UnHombreAlto/Bachelor_Biosignalgenerator_HTWK/Platinen_Design/Platine_1/WhatsApp Image 2026-09-02 at 13.56.45(1).jpeg

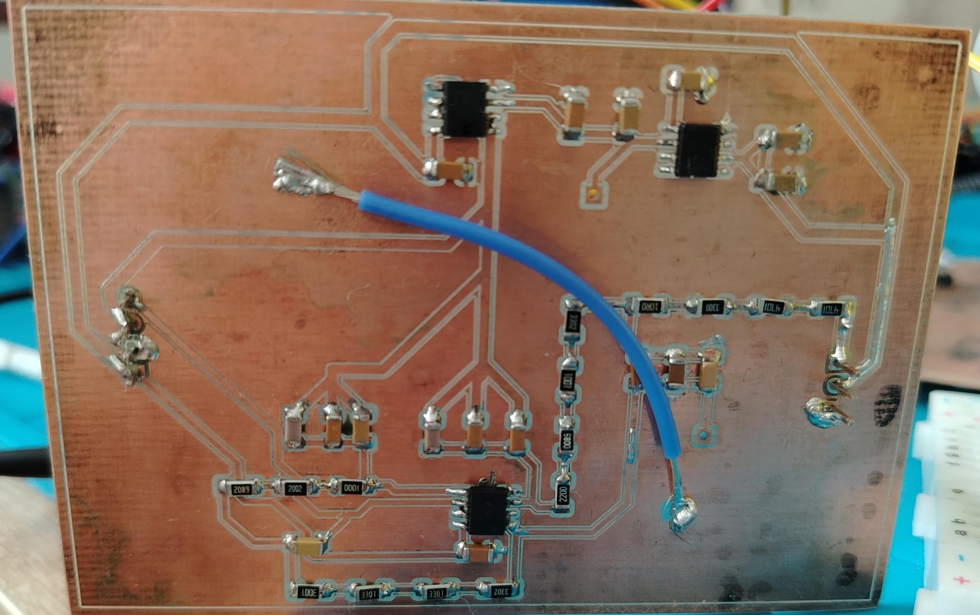
Platinen_Design/Platine_1/WhatsApp Image 2026-09-02 at 13.56.45(1).jpeg
