UnHombreAlto/Bachelor_Biosignalgenerator_HTWK/Platinen_Design/Platine_2/WhatsApp Image 2026-09-02 at 13.56.45.jpeg

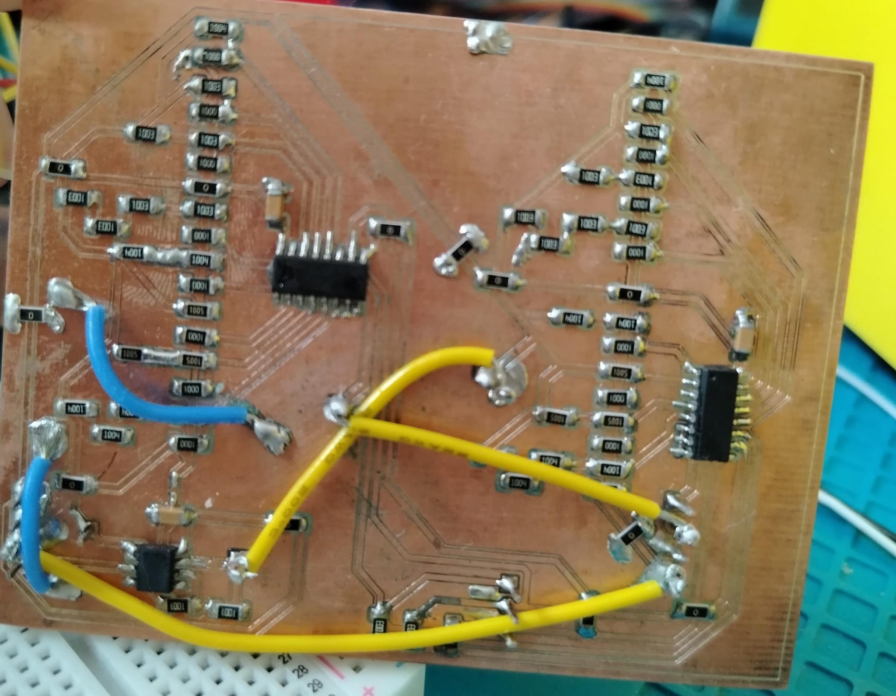
Platinen_Design/Platine_2/WhatsApp Image 2026-09-02 at 13.56.45.jpeg
