UnHombreAlto/Bachelor_Biosignalgenerator_HTWK/README.md

# Bachelor_Biosignalgenerator_HTWK
Sammlung des Materials zur Bachelorarbeit Biosignalgenerator
