UnHombreAlto/Bachelor_Biosignalgenerator_HTWK/erste_Versuche/WhatsApp Image 2026-09-02 at 13.54.11.jpeg

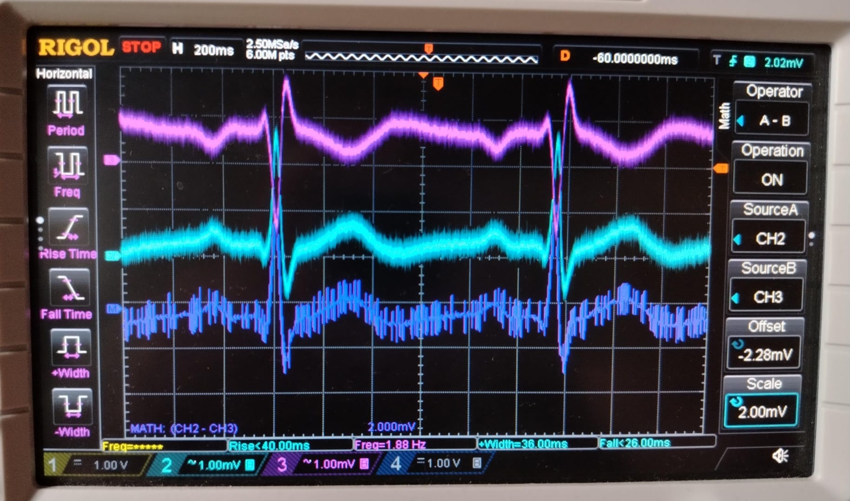
erste_Versuche/WhatsApp Image 2026-09-02 at 13.54.11.jpeg
