UnHombreAlto/Bachelor_Biosignalgenerator_HTWK/Gehäuse_Desgin/Biosignal.FCStd

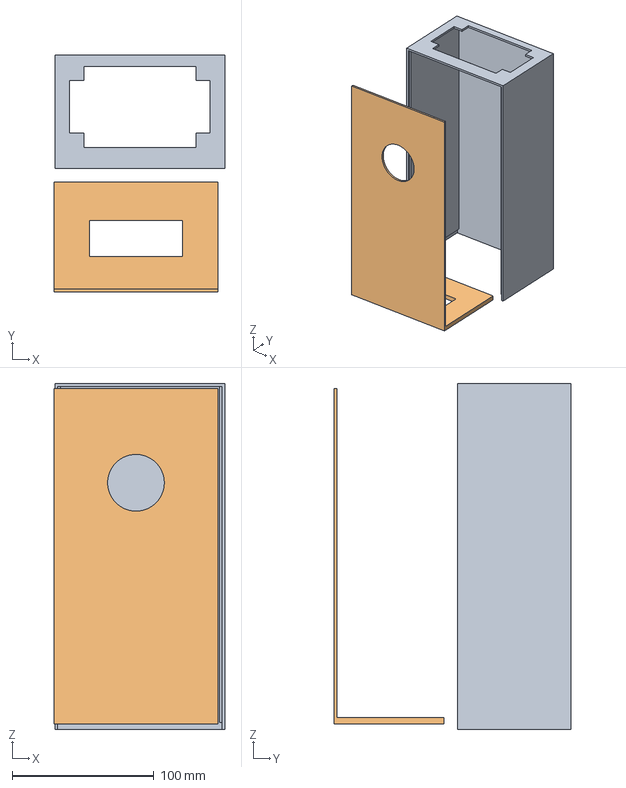
[picture p4: CAD file, 2026-09-08]
Gehäuse_Desgin/Biosignal.FCStd
120.5 x 167.0 x 244.0 mm
Base_Plate
Lid
