UnHombreAlto/Bachelor_Biosignalgenerator_HTWK/Platinen_Design/Platine_2/BiosignalGEN_SOIC_Klein.kicad_pcb

## KiCad design Platinen_Design/Platine_2/BiosignalGEN_SOIC_Klein.kicad_pcb (2026-09-02)

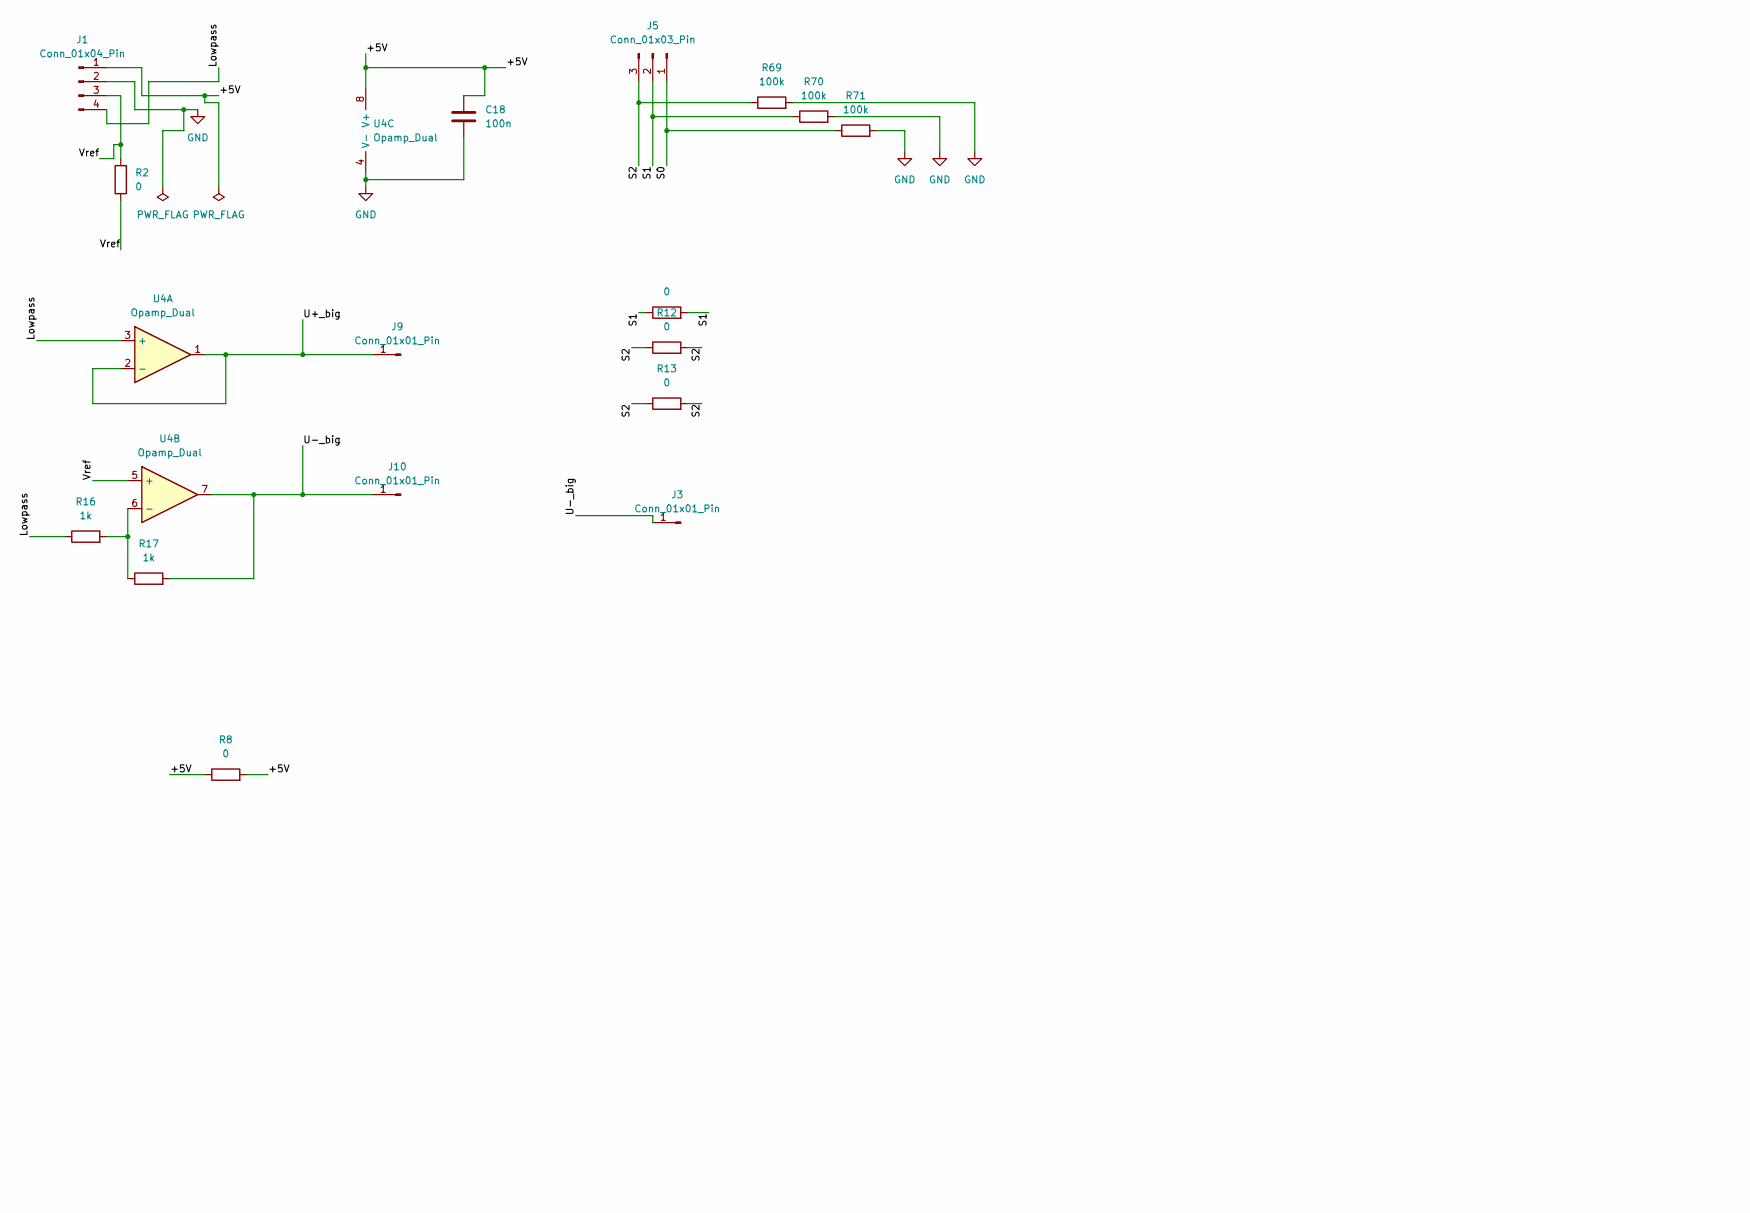
[picture p5: schematic BiosignalGEN_SOIC_Klein.kicad_sch, part in row 1, column 1]

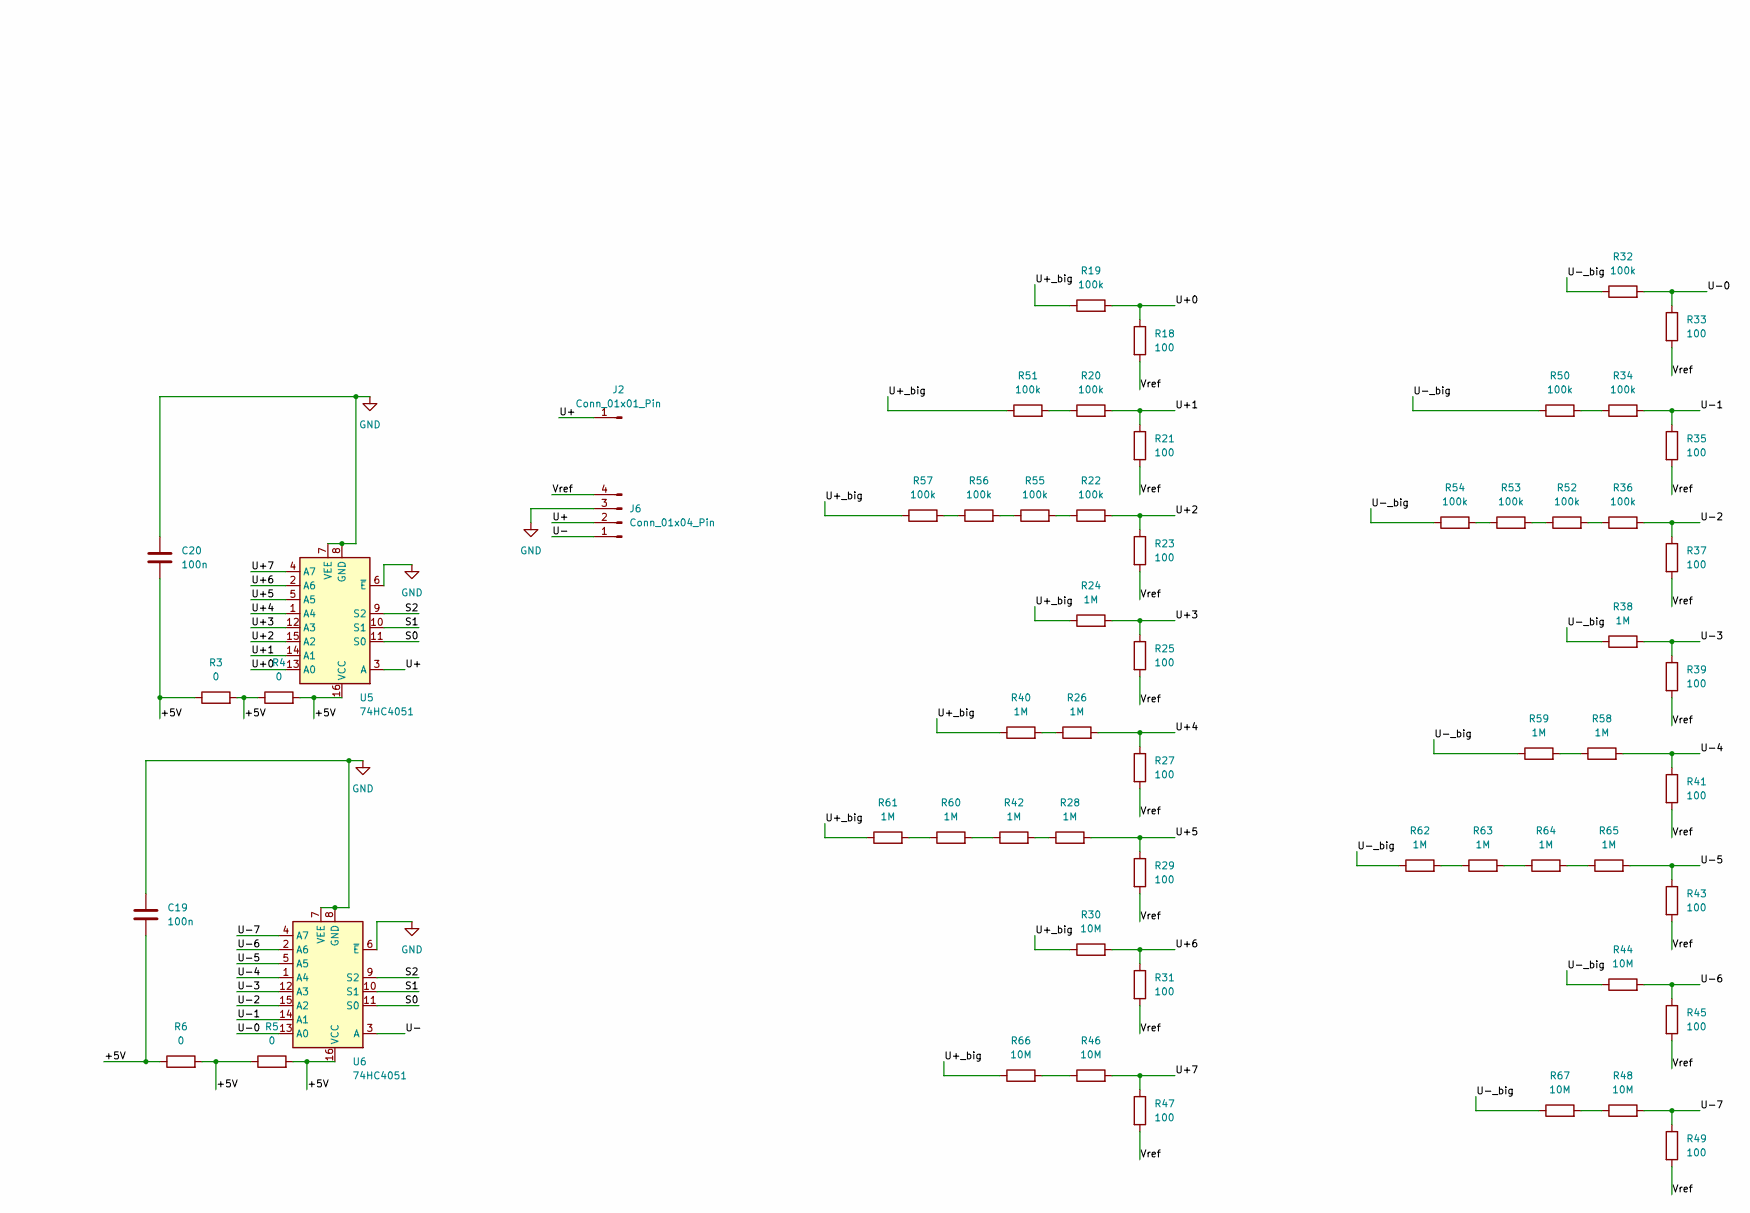
[picture p6: schematic BiosignalGEN_SOIC_Klein.kicad_sch, part in row 1, column 2]

Parts:
C18, C19, C20: 100n; C_1206_3216Metric_Pad1.33x1.80mm_HandSolder
J1, J6: Conn_01x04_Pin; PinHeader_1x04_P2.54mm_Vertical
J2, J3, J9, J10: Conn_01x01_Pin; PinHeader_1x01_P2.54mm_Vertical
J5: Conn_01x03_Pin; PinHeader_1x03_P2.54mm_Vertical
R2, R3, R4, R5, R6, R8, R11, R12, R13: 0; R_1206_3216Metric_Pad1.30x1.75mm_HandSolder
R16, R17: 1k; R_1206_3216Metric_Pad1.30x1.75mm_HandSolder
R18, R21, R23, R25, R27, R29, R31, R33, R35, R37, R39, R41, R43, R45, R47, R49: 100; R_1206_3216Metric_Pad1.30x1.75mm_HandSolder
R19, R20, R22, R32, R34, R36, R50, R51, R52, R53, R54, R55, R56, R57, R69, R70, R71: 100k; R_1206_3216Metric_Pad1.30x1.75mm_HandSolder
R24, R26, R28, R38, R40, R42, R58, R59, R60, R61, R62, R63, R64, R65: 1M; R_1206_3216Metric_Pad1.30x1.75mm_HandSolder
R30, R44, R46, R48, R66, R67: 10M; R_1206_3216Metric_Pad1.30x1.75mm_HandSolder
U4: Opamp_Dual; SOIC-8_3.9x4.9mm_P1.27mm
U5, U6: 74HC4051; SO-16_3.9x9.9mm_P1.27mm

Connections:
/+5V: C18.1, C19.2, C20.2, J1.1, R3.1, R3.2, R4.1, R4.2, R5.1, R5.2, R6.1, R6.2, R8.1, R8.2, U4.8 (V+), U5.16 (VCC), U6.16 (VCC)
/Lowpass: J1.4, R16.1, U4.3 (+)
/S0: J5.1, R71.1, U5.11 (S0), U6.11 (S0)
/S1: J5.2, R11.1, R11.2, R70.1, U5.10 (S1), U6.10 (S1)
/S2: J5.3, R12.1, R12.2, R13.1, R13.2, R69.1, U5.9 (S2), U6.9 (S2)
/U+: J2.1 (Pin_1_1), J6.2, U5.3 (A)
/U+0: R18.1, R19.2, U5.13 (A0)
/U+1: R20.2, R21.1, U5.14 (A1)
/U+2: R22.2, R23.1, U5.15 (A2)
/U+3: R24.2, R25.1, U5.12 (A3)
/U+4: R26.2, R27.1, U5.1 (A4)
/U+5: R28.2, R29.1, U5.5 (A5)
/U+6: R30.2, R31.1, U5.2 (A6)
/U+7: R46.2, R47.1, U5.4 (A7)
/U+_big: J9.1 (Pin_1_1), R19.1, R24.1, R30.1, R40.1, R51.1, R57.1, R61.1, R66.1, U4.1, U4.2 (-)
/U-: J6.1, U6.3 (A)
/U-0: R32.2, R33.1, U6.13 (A0)
/U-1: R34.2, R35.1, U6.14 (A1)
/U-2: R36.2, R37.1, U6.15 (A2)
/U-3: R38.2, R39.1, U6.12 (A3)
/U-4: R41.1, R58.2, U6.1 (A4)
/U-5: R43.1, R65.2, U6.5 (A5)
/U-6: R44.2, R45.1, U6.2 (A6)
/U-7: R48.2, R49.1, U6.4 (A7)
/U-_big: J3.1 (Pin_1_1), J10.1 (Pin_1_1), R17.2, R32.1, R38.1, R44.1, R50.1, R54.1, R59.1, R62.1, R67.1, U4.7
/Vref: J1.3, J6.4, R2.1, R2.2, R18.2, R21.2, R23.2, R25.2, R27.2, R29.2, R31.2, R33.2, R35.2, R37.2, R39.2, R41.2, R43.2, R45.2, R47.2, R49.2, U4.5 (+)
GND: C18.2, C19.1, C20.1, J1.2, J6.3, R69.2, R70.2, R71.2, U4.4 (V-), U5.6 (~E), U5.7 (VEE), U5.8 (GND), U6.6 (~E), U6.7 (VEE), U6.8 (GND)
unnamed: R20.1, R51.2
unnamed: R22.1, R55.2
unnamed: R26.1, R40.2
unnamed: R28.1, R42.2
unnamed: R34.1, R50.2
unnamed: R36.1, R52.2
unnamed: R42.1, R60.2
unnamed: R46.1, R66.2
unnamed: R48.1, R67.2
unnamed: R52.1, R53.2
unnamed: R53.1, R54.2
unnamed: R55.1, R56.2
unnamed: R56.1, R57.2
unnamed: R58.1, R59.2
unnamed: R60.1, R61.2
unnamed: R62.2, R63.1
unnamed: R63.2, R64.1
unnamed: R64.2, R65.1
unnamed: R16.2, R17.1, U4.6 (-)

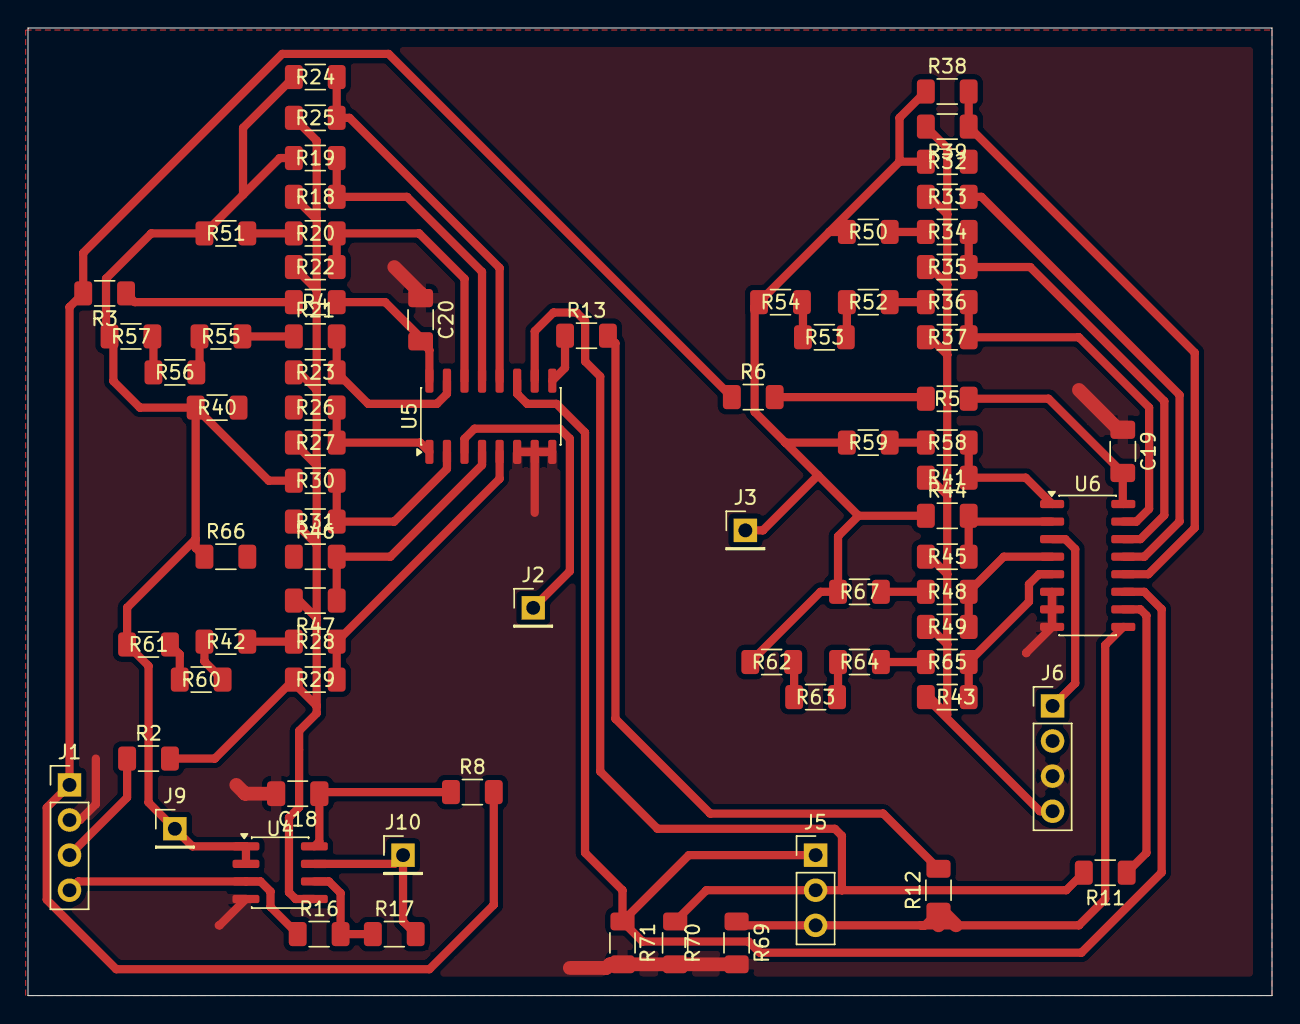
[picture p7: board BiosignalGEN_SOIC_Klein.kicad_pcb from above]

Board: 2 copper layers, 90.0 x 70.0 mm, 77 parts (0 on the bottom side), 46 nets.
