UnHombreAlto/Bachelor_Biosignalgenerator_HTWK/Platinen_Design/Platine_1/BiosignalGEN_SOIC_Klein_P2.kicad_pcb

## KiCad design Platinen_Design/Platine_1/BiosignalGEN_SOIC_Klein_P2.kicad_pcb (2026-09-02)

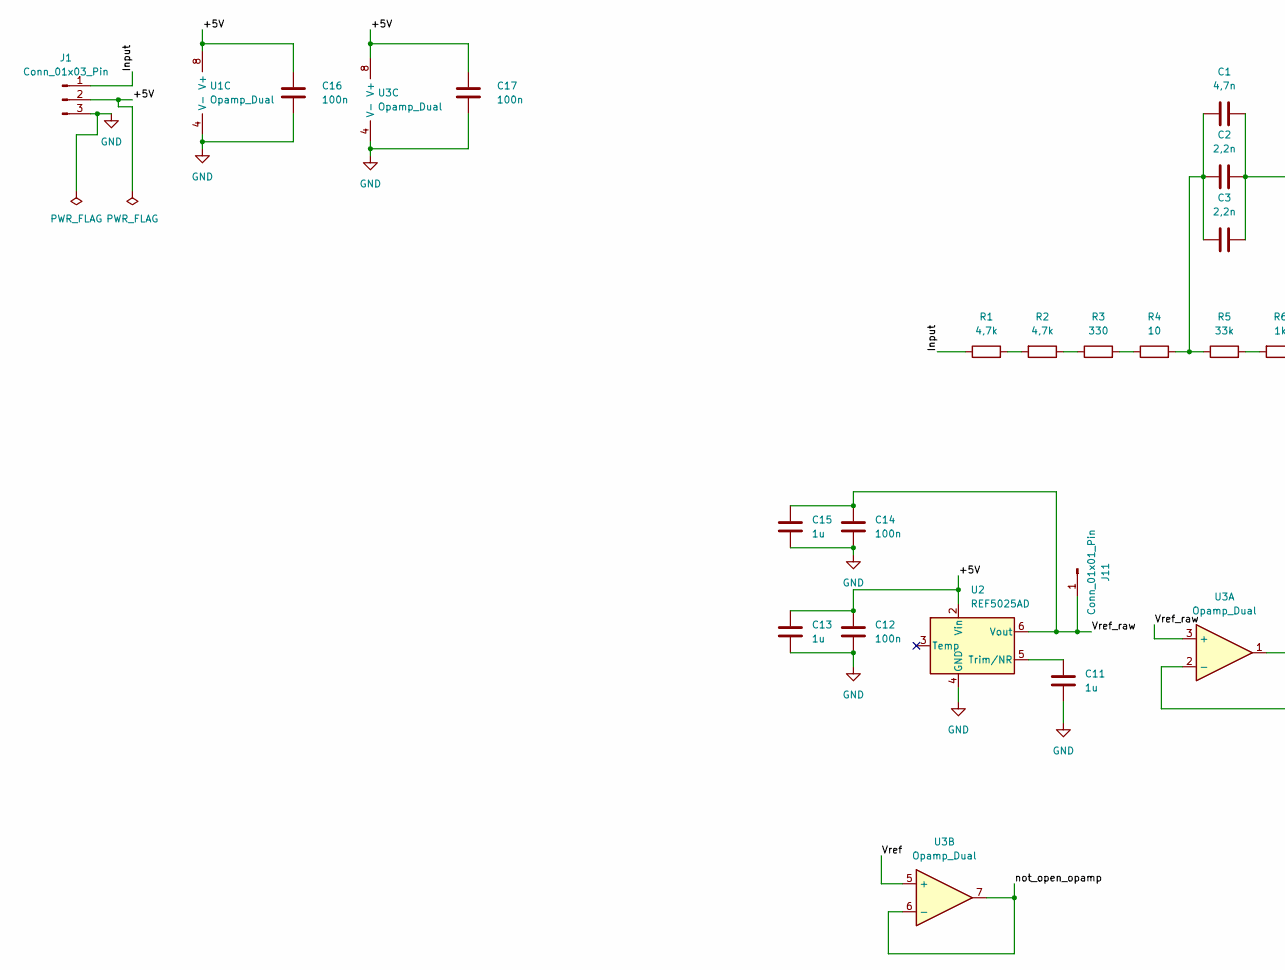
[picture p8: schematic BiosignalGEN_SOIC_Klein_P2.kicad_sch, part in row 1, column 1]

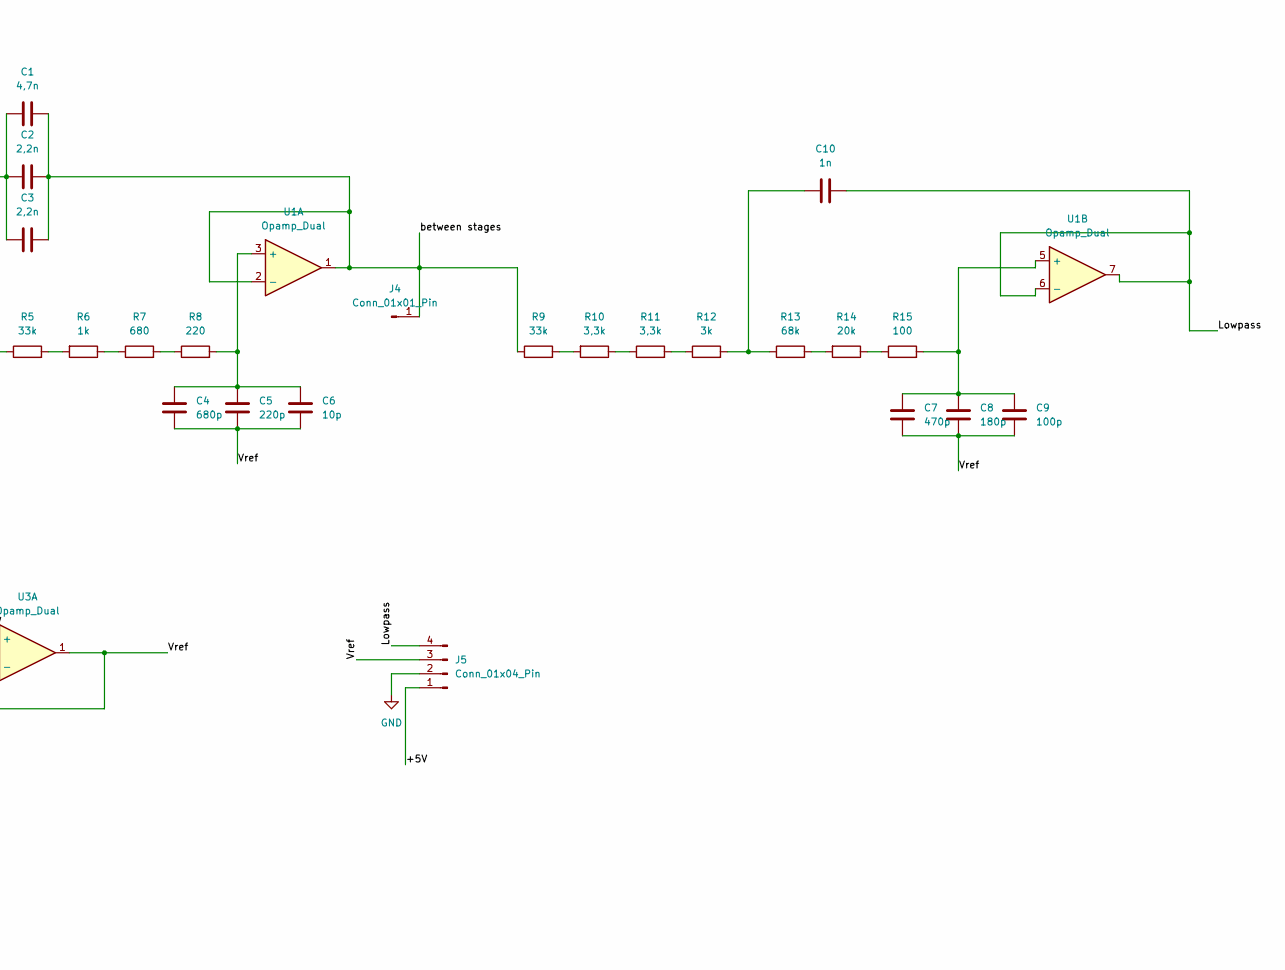
[picture p9: schematic BiosignalGEN_SOIC_Klein_P2.kicad_sch, part in row 1, column 2]

Parts:
C1: 4,7n; C_1206_3216Metric_Pad1.33x1.80mm_HandSolder
C2, C3: 2,2n; C_1206_3216Metric_Pad1.33x1.80mm_HandSolder
C4: 680p; C_1206_3216Metric_Pad1.33x1.80mm_HandSolder
C5: 220p; C_1206_3216Metric_Pad1.33x1.80mm_HandSolder
C6: 10p; C_1206_3216Metric_Pad1.33x1.80mm_HandSolder
C7: 470p; C_1206_3216Metric_Pad1.33x1.80mm_HandSolder
C8: 180p; C_1206_3216Metric_Pad1.33x1.80mm_HandSolder
C9: 100p; C_1206_3216Metric_Pad1.33x1.80mm_HandSolder
C10: 1n; C_1206_3216Metric_Pad1.33x1.80mm_HandSolder
C11, C13, C15: 1u; C_1206_3216Metric_Pad1.33x1.80mm_HandSolder
C12, C14, C16, C17: 100n; C_1206_3216Metric_Pad1.33x1.80mm_HandSolder
J1: Conn_01x03_Pin; PinHeader_1x03_P2.54mm_Vertical
J4, J11: Conn_01x01_Pin; PinHeader_1x01_P2.54mm_Vertical
J5: Conn_01x04_Pin; PinHeader_1x04_P2.54mm_Vertical
R1, R2: 4,7k; R_1206_3216Metric_Pad1.30x1.75mm_HandSolder
R3: 330; R_1206_3216Metric_Pad1.30x1.75mm_HandSolder
R4: 10; R_1206_3216Metric_Pad1.30x1.75mm_HandSolder
R5, R9: 33k; R_1206_3216Metric_Pad1.30x1.75mm_HandSolder
R6: 1k; R_1206_3216Metric_Pad1.30x1.75mm_HandSolder
R7: 680; R_1206_3216Metric_Pad1.30x1.75mm_HandSolder
R8: 220; R_1206_3216Metric_Pad1.30x1.75mm_HandSolder
R10, R11: 3,3k; R_1206_3216Metric_Pad1.30x1.75mm_HandSolder
R12: 3k; R_1206_3216Metric_Pad1.30x1.75mm_HandSolder
R13: 68k; R_1206_3216Metric_Pad1.30x1.75mm_HandSolder
R14: 20k; R_1206_3216Metric_Pad1.30x1.75mm_HandSolder
R15: 100; R_1206_3216Metric_Pad1.30x1.75mm_HandSolder
U1, U3: Opamp_Dual; SOIC-8_3.9x4.9mm_P1.27mm
U2: REF5025AD; SOIC-8_3.9x4.9mm_P1.27mm

Connections:
/+5V: C12.1, C13.1, C16.1, C17.1, J1.2, J5.1, U1.8 (V+), U2.2 (Vin), U3.8 (V+)
/Input: J1.1, R1.1
/Lowpass: C10.2, J5.4, U1.6 (-), U1.7
/Vref: C4.1, C5.1, C6.1, C7.1, C8.1, C9.1, J5.3, U3.1, U3.2 (-), U3.5 (+)
/Vref_raw: C14.1, C15.1, J11.1 (Pin_1_1), U2.6 (Vout), U3.3 (+)
/between stages: C1.2, C2.2, C3.2, J4.1 (Pin_1_1), R9.1, U1.1, U1.2 (-)
/not_open_opamp: U3.6 (-), U3.7
GND: C11.2, C12.2, C13.2, C14.2, C15.2, C16.2, C17.2, J1.3, J5.2, U1.4 (V-), U2.4 (GND), U3.4 (V-)
unnamed: C1.1, C2.1, C3.1, R4.2, R5.1
unnamed: C10.1, R12.2, R13.1
unnamed: R1.2, R2.2
unnamed: R2.1, R3.1
unnamed: R3.2, R4.1
unnamed: R5.2, R6.2
unnamed: R6.1, R7.1
unnamed: R7.2, R8.1
unnamed: R10.1, R11.1
unnamed: R9.2, R10.2
unnamed: R11.2, R12.1
unnamed: R13.2, R14.2
unnamed: R14.1, R15.1
unnamed: C4.2, C5.2, C6.2, R8.2, U1.3 (+)
unnamed: C7.2, C8.2, C9.2, R15.2, U1.5 (+)
unnamed: C11.1, U2.5 (Trim/NR)

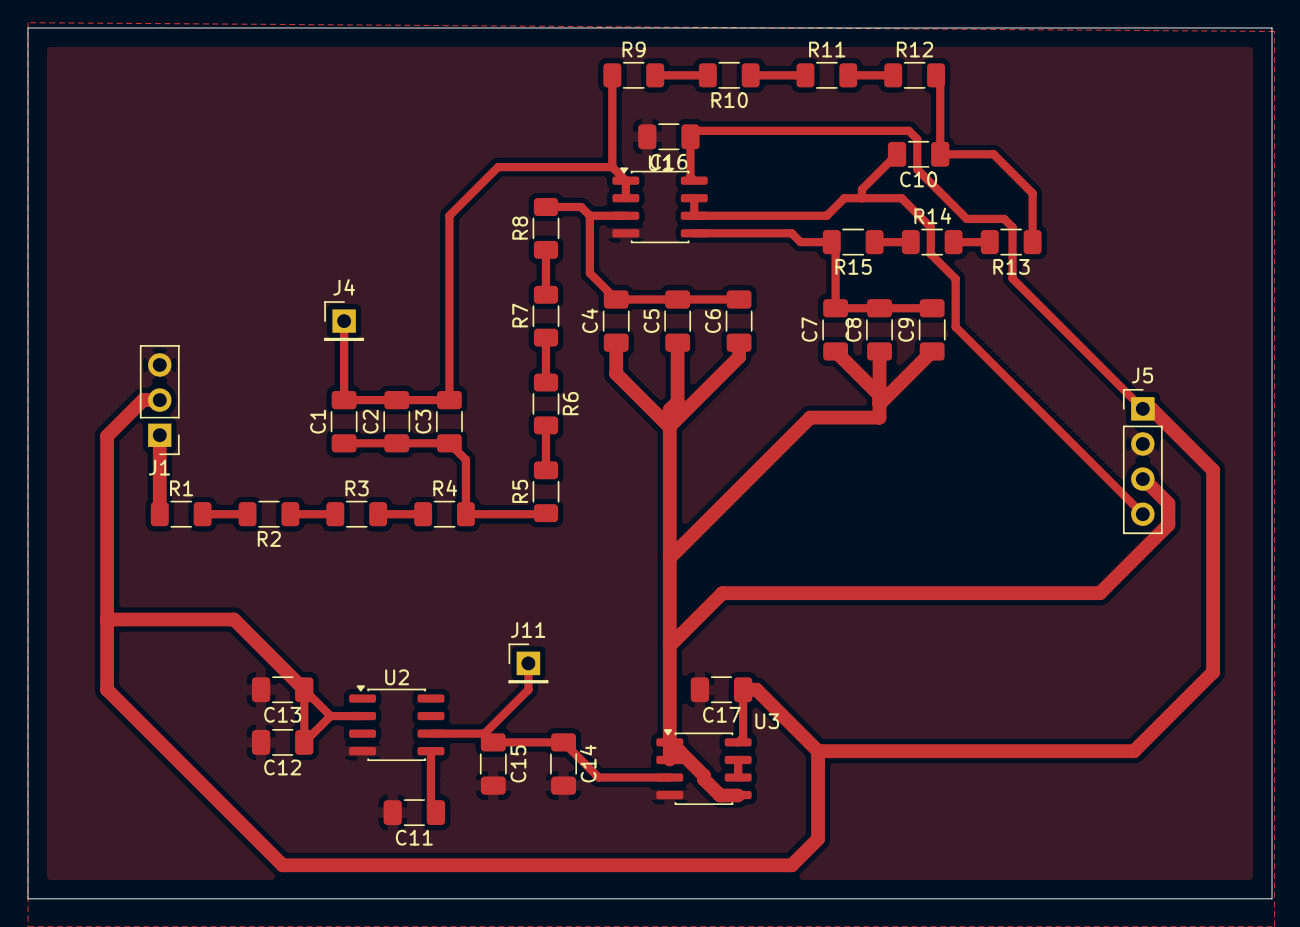
[picture p10: board BiosignalGEN_SOIC_Klein_P2.kicad_pcb from above]

Board: 2 copper layers, 90.0 x 63.0 mm, 39 parts (0 on the bottom side), 24 nets.
