UnHombreAlto/Bachelor_Biosignalgenerator_HTWK/Code/real_signal_tables.h

#pragma once
#include "config.h"

// ================= Datenbasierte Signal-Tabellen =================

// - EKG: MIT-BIH Arrhythmia Database, Record 100, Kanal MLII, normal/gemittelter Beat.
// - EEG: EEG Motor Movement/Imagery Dataset, S001R01 Augen offen, S001R02 Augen geschlossen.
// - EMG: Examples of Electromyograms, emg_healthy.

static const int16_t realMitBih100MliiCentered[SIGNAL_TABLE_SIZE] = {
  -162, -162, -162, -162, -162, -162, -162, -161, -161, -161, -161, -161, -161, -161, -160, -160,
  -160, -160, -160, -160, -159, -159, -159, -159, -159, -159, -159, -158, -158, -158, -158, -158,
  -158, -158, -157, -157, -157, -157, -157, -157, -157, -156, -156, -156, -156, -156, -156, -156,
  -156, -155, -155, -155, -155, -155, -155, -155, -154, -154, -154, -154, -154, -154, -154, -154,
  -153, -153, -153, -153, -153, -153, -153, -153, -152, -152, -152, -152, -152, -152, -152, -151,
  -151, -151, -151, -151, -151, -150, -150, -150, -150, -150, -149, -149, -149, -149, -148, -148,
  -148, -147, -147, -146, -146, -146, -145, -144, -144, -143, -143, -142, -141, -140, -139, -138,
  -137, -136, -135, -134, -133, -131, -130, -128, -126, -125, -123, -121, -119, -116, -114, -112,
  -109, -106, -103, -100, -97, -94, -90, -87, -83, -79, -75, -71, -67, -62, -58, -53,
  -48, -43, -38, -33, -28, -23, -17, -12, -6, -1, 5, 10, 16, 22, 27, 33,
  38, 44, 49, 54, 59, 64, 69, 74, 79, 83, 87, 91, 95, 98, 102, 105,
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
  0, 0, 0, 0, 0, 0, 0, 0, 0, 0, 0, 0, 0, 0, 0, 0,
  0, 0, 0, 0, 0, 0, 0, 0, 0, 0, 0, 0, 0, 0, 0, 0,
  0, 0, 0, 0, 0, 0, 0, 0, 0, 0, 0, 0, 0, 0, 0, 0,
  0, 0, 0, 0, 0, 0, 0, 0, 0, 0, 0, 0, 0, 0, 0, 0,
  0, 0, 0, 0, 0, 0, 0, 0, 0, 0, 0, 0, 0, 0, 0, 0,
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
};
